PucklaJ/3AHEL_Werkstaettenprojekt/README.md

# 3AHEL_Werkstaettenprojekt
Hier findet man alle Dateien für unser Werktättenprojekt

Jahrgang: 2016/17
Personen:
	- Karayanov Vitaliy
	- Mujic Haris
	- Pucher Jonas

Arbeitszeit: 11x8 Schulstunden
