PucklaJ/3AHEL_Werkstaettenprojekt/Arbeitsnachweis/ARBEITSZEITNACHWEIS KW11.odt

ARBEITSZEITNACHWEIS

3ABCHEL

Werkstättenprojekt 2016/2017

Projektname: RGB-LED-Matrix-Konsole

Datum: 17.03.2017 KW: 11

Status: Schaltplan fast fertig

Name | | Durchgeführte Arbeiten | | Stunden
Mujic Haris | | Auf Steckbrett stecken(Matrix testen) | | 8h
Karayanov Vitaliy | | Auf Steckbrett stecken(Matrix testen) | | 8h
Pucher Jonas | | Auf Steckbrett stecken(Matrix testen), Arduino programmieren | | 8h
| | | Gesamt - Personalstunden | 24h

Datum: 17.03.2017
