PucklaJ/3AHEL_Werkstaettenprojekt/Stückliste.ods

Name | Anzahl | Preis (1 Stk) | Preis | Link | Bestellnummer
32x32 Matrix | 1 | € 63,02 | € 63,02 | https://www.amazon.de/Adafruit-RGB-LED-Panel-32x32-Matrix/dp/B00M40XWBI | Bestellt
Arduino Mega | 1 | € 35,28 | € 35,28 | https://www.amazon.de/Arduino-Mega-2560-R3-Microcontroller/dp/B0046AMGW0 | Bestellt
7 Segment Anzeige | 2 | € 2,97 | € 5,94 | http://at.rs-online.com/web/p/led-displays/8134801/ | 813-4801
Potentiometer | 1 | € 1,92 | € 1,92 | https://www.reichelt.at/4mm-Potis-mono/PO4M-LIN-220K/3/index.html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 | PC16BU 220KA
74HC165 | 4 | € 0,32 | € 1,28 | http://at.rs-online.com/web/p/zahler-und-schieberegister/1776629/ | 177-6629
MAX7219 | 1 | € 7,44 | € 7,44 | http://at.rs-online.com/web/p/zahler-und-schieberegister/7390136/ | 739-0136
DIN-Buchse Console | 4 | € 0,60 | € 2,40 | https://www.reichelt.at/Diodeneinbaubuchsen/MABPM-5S/3/index.html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 | MABPM 5S
Verbindungs-Kabel | 4 | € 1,41 | € 5,64 | https://www.reichelt.at/A-V-Kabel-DIN-/AVK-123/3/index.html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 | AVK 123
Kontrolltaster | 16 | € 1,49 | € 23,84 | http://at.rs-online.com/web/p/tastaturschalter/0102311/?origin=PSF_428099 | 102-311
Aktionstaster | 8 | € 1,43 | € 11,44 | http://at.rs-online.com/web/p/tastaturschalter/0102248/?origin=PSF_428099 | 102-248
Arduino-Buchsenleiste | 1 | € 3,71 | € 3,71 | http://at.rs-online.com/web/p/leiterplatten-buchsen/2304938/ | 230-4938
Buchsen-Buchsenleiste | 2 | € 1,54 | € 3,08 | http://at.rs-online.com/web/p/leiterplatten-buchsen/7655705/ | 765-5705
7Seg-Buchsenleiste | 5 | € 0,45 | € 2,26 | http://at.rs-online.com/web/p/leiterplatten-buchsen/6816823/ | 681-6823
Matrix-Stiftleiste | 1 | € 0,49 | € 0,49 | http://at.rs-online.com/web/p/leiterplatten-header/8323500/ | 832-3500
Spannungsregler | 1 | € 2,95 | € 2,95 | https://www.neuhold-elektronik.at/catshop/product_info.php?products_id=4414 | N9505
Kondensator 100n | 29 | € 0,04 | € 1,16 | https://www.reichelt.at/Vielschicht-SMD-G0805/X7R-0805-CG-100N/3/index.html?ACTION=3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 | X7R 0805 CG 100N
Widerstand 10k | 24 | € 0,02 | € 0,48 | https://www.reichelt.at/SMD-1206-von-1-bis-910-kOhm/RND-1206-1-10K/3/index.html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 | RND 1206 1 10K
Widerstand 200 | 1 | € 0,02 | € 0,02 | https://www.reichelt.at/SMD-1206-von-0-bis-910-Ohm/RND-1206-1-200/3/index.html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 | RND 1206 1 200
Netzteil | 1 | € 13,85 | € 13,85 | https://www.amazon.de/CSL-verschiedene-Adapter-Aufs%C3%A4tze-%C3%9Cberspannung-Kurzschluss/dp/B01MFCR6W2 | Bestellt
 |  | Summe | € 186,20
 |  | Schulrabatt | € 60,00
 |  | Noch zu zahlen | € 87,90
Person | Selbst | Für Schule | Für Jonas | Summe
Mujic Haris | € 4,62 | € 4,68 | € 32,77 | € 42,07
Karayanov Vitaliy | € 4,62 | € 4,68 | € 32,77 | € 42,07
Pucher Jonas | € 4,62 | € 4,68 | € 32,77 | € 42,07
Noch nicht bestellt!!
