PucklaJ/3AHEL_Werkstaettenprojekt/(list of files, cad)

Other CAD files:
3AHEL_LED_Matrix.skp
3AHEL_LED_Matrix_new.skp
