PucklaJ/3AHEL_Werkstaettenprojekt/Eagle_Verzeichnisse/Projekte/Matrix-Konsole/console1_löt_top.pdf

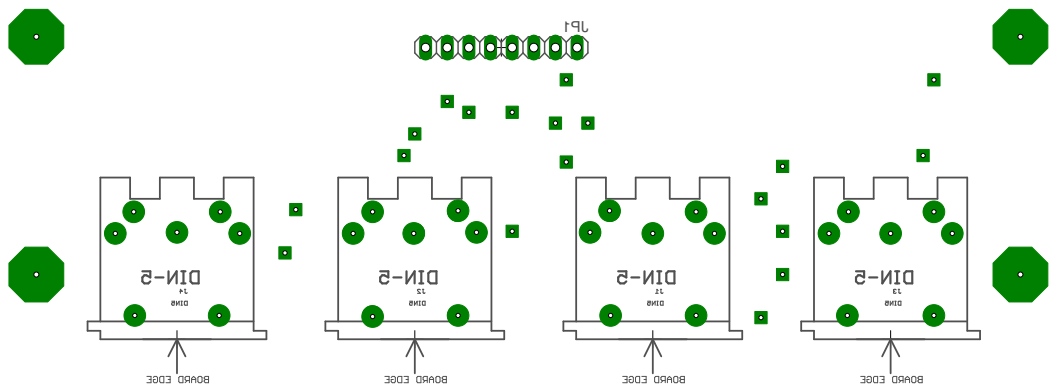
[picture p18: page 1]
