PucklaJ/3AHEL_Werkstaettenprojekt/Eagle_Verzeichnisse/Projekte/Matrix-Konsole/console2_löt_bot.pdf

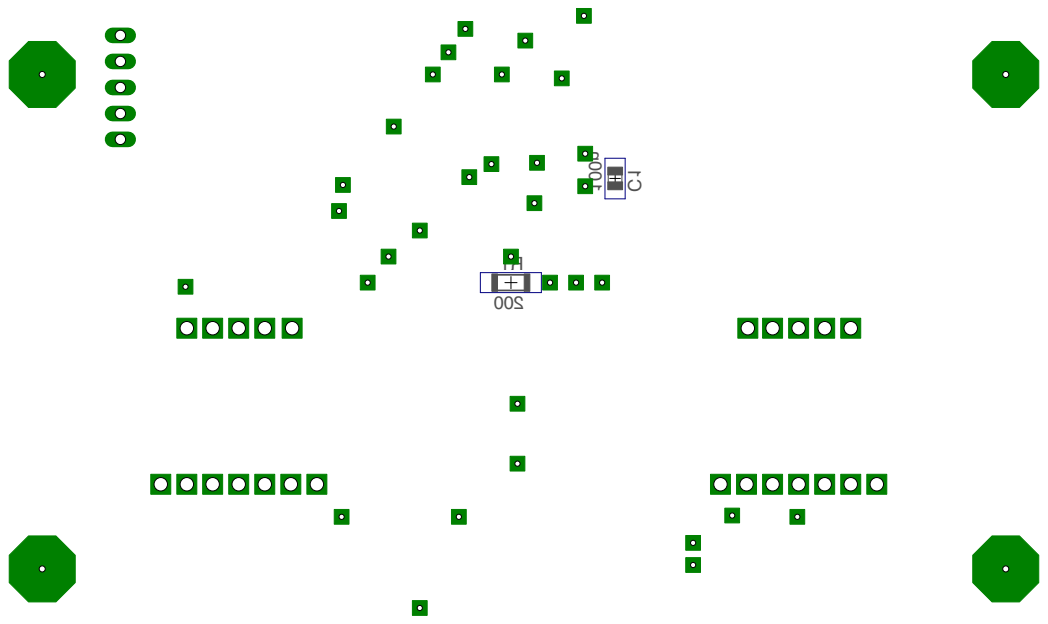
[picture p19: page 1]
