PucklaJ/3AHEL_Werkstaettenprojekt/Eagle_Verzeichnisse/Projekte/Matrix-Konsole/console2_löt_top.pdf

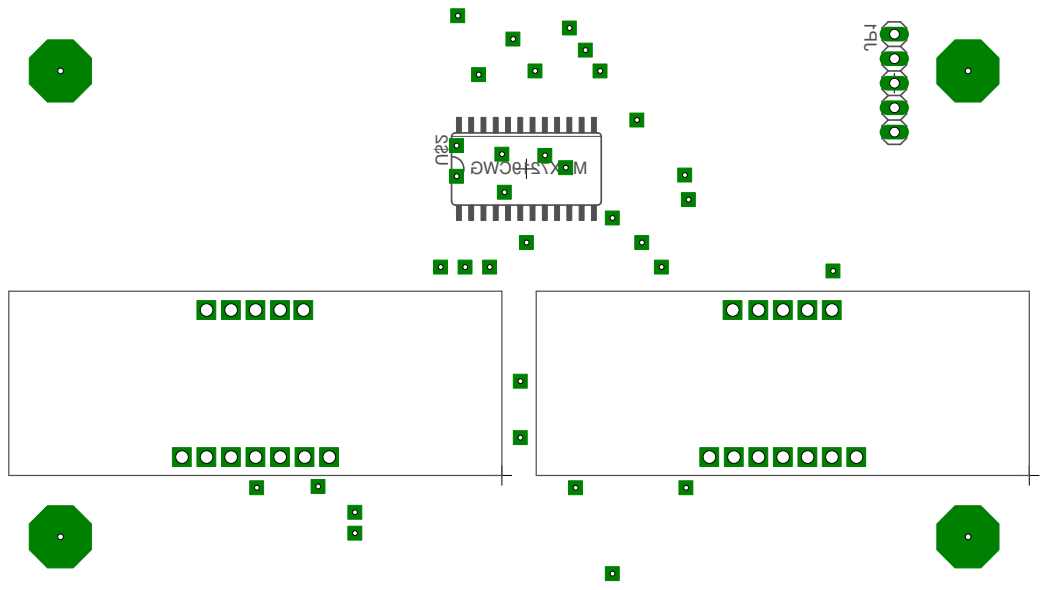
[picture p20: page 1]
