PucklaJ/3AHEL_Werkstaettenprojekt/Eagle_Verzeichnisse/Projekte/Matrix-Konsole/console_löt_top.pdf

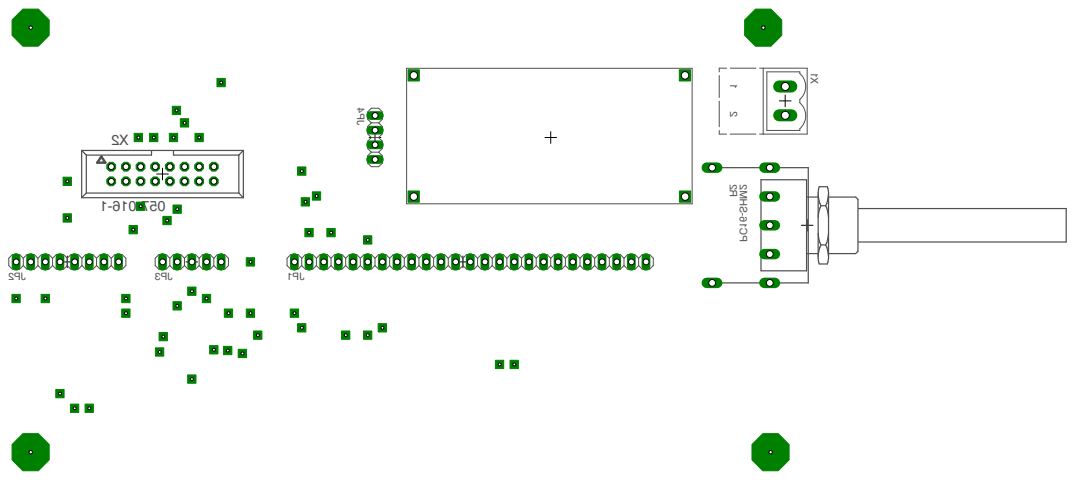
[picture p21: page 1]
