PucklaJ/3AHEL_Werkstaettenprojekt/Eagle_Verzeichnisse/Projekte/Matrix-Konsole/controller_löt_top.pdf

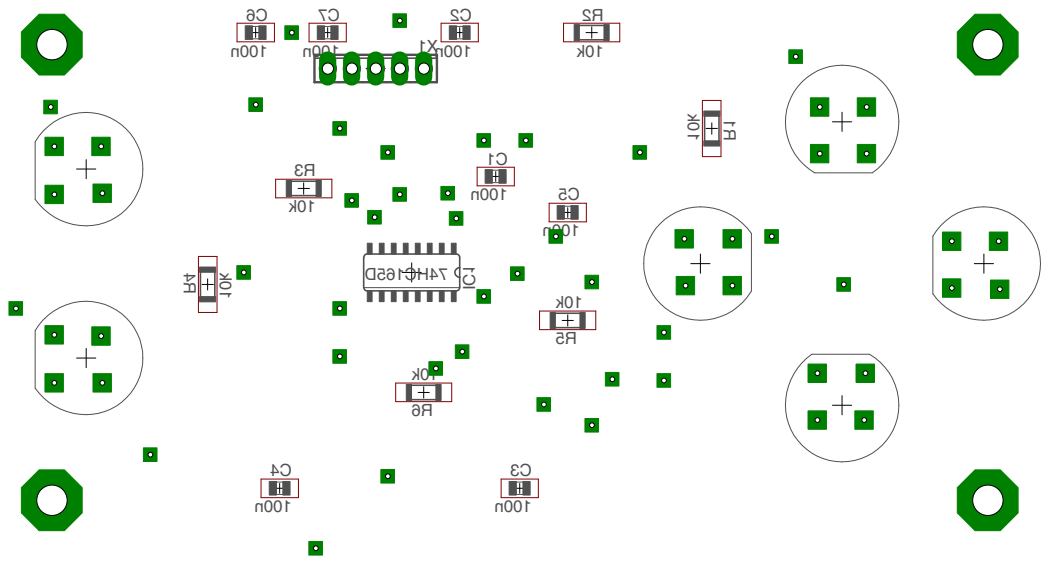
[picture p22: page 1]
