PucklaJ/3AHEL_Werkstaettenprojekt/Eagle_Verzeichnisse/Projekte/Matrix-Konsole/console.pdf

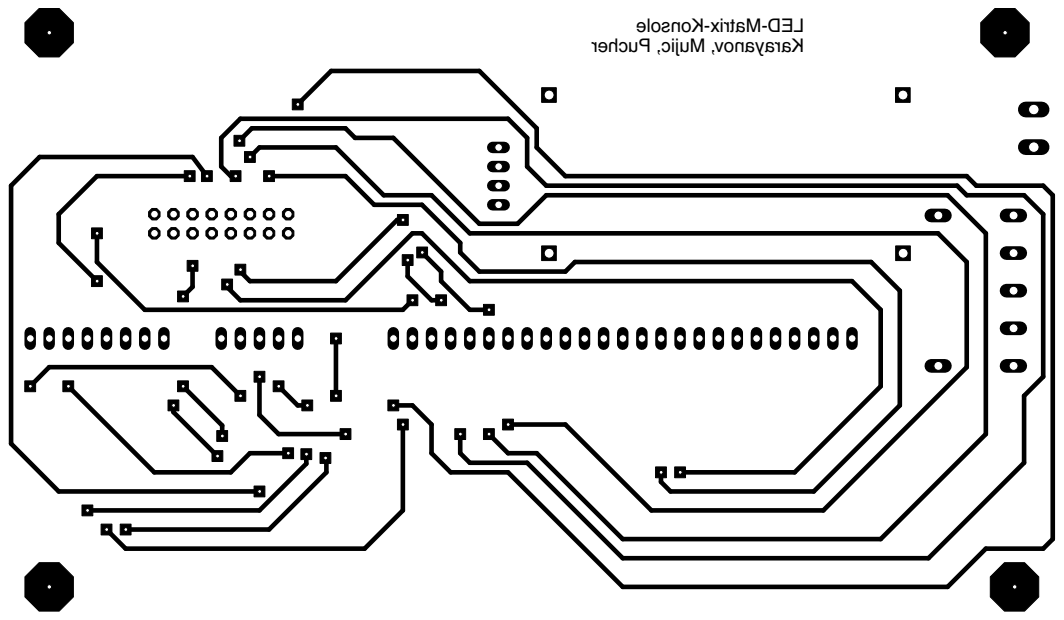
[picture p23: page 1]

el osnoK- xirt a M- DEL

r ehcuP, cij u M, vonayar aK
