PucklaJ/3AHEL_Werkstaettenprojekt/Eagle_Verzeichnisse/Projekte/Matrix-Konsole/console1_top.pdf

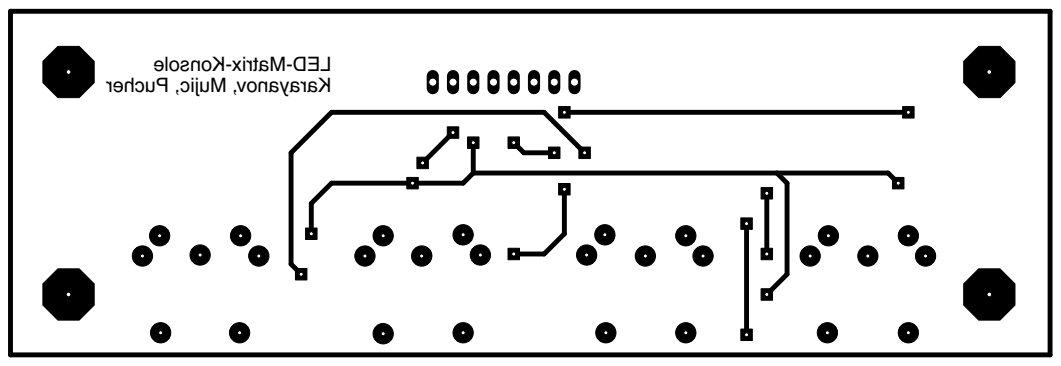
[picture p25: page 1]

el osnoK- xirt a M- DEL

r ehcuP, cij u M, vonayar aK
