PucklaJ/3AHEL_Werkstaettenprojekt/Eagle_Verzeichnisse/Projekte/Matrix-Konsole/console_top.pdf

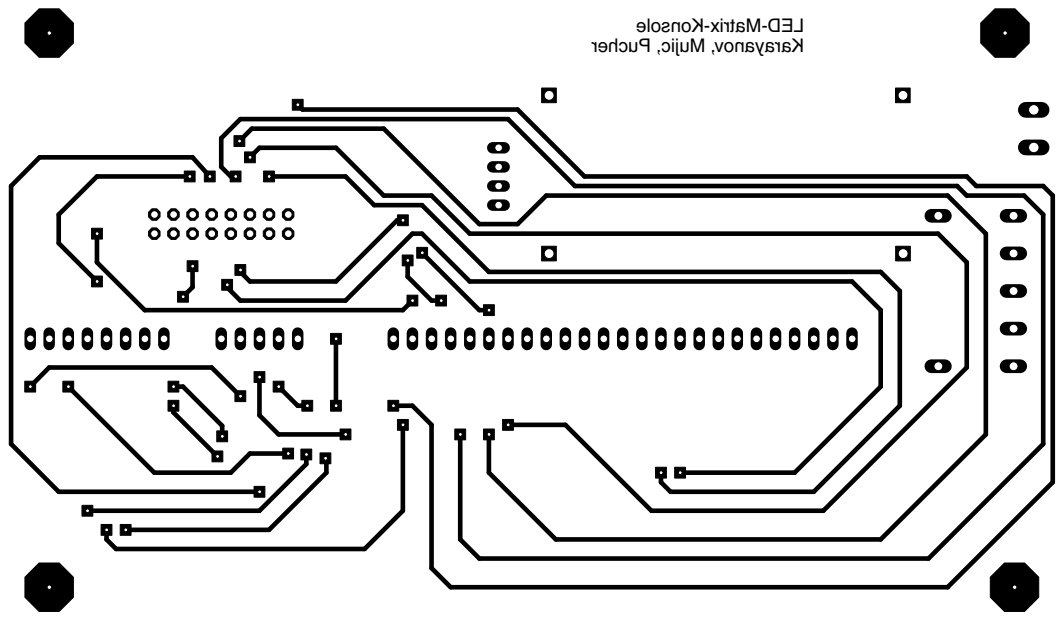
[picture p29: page 1]

el osnoK- xirt a M- DEL

r ehcuP, cij u M, vonayar aK
