PucklaJ/3AHEL_Werkstaettenprojekt/Eagle_Verzeichnisse/Projekte/Matrix-Konsole/controller.pdf

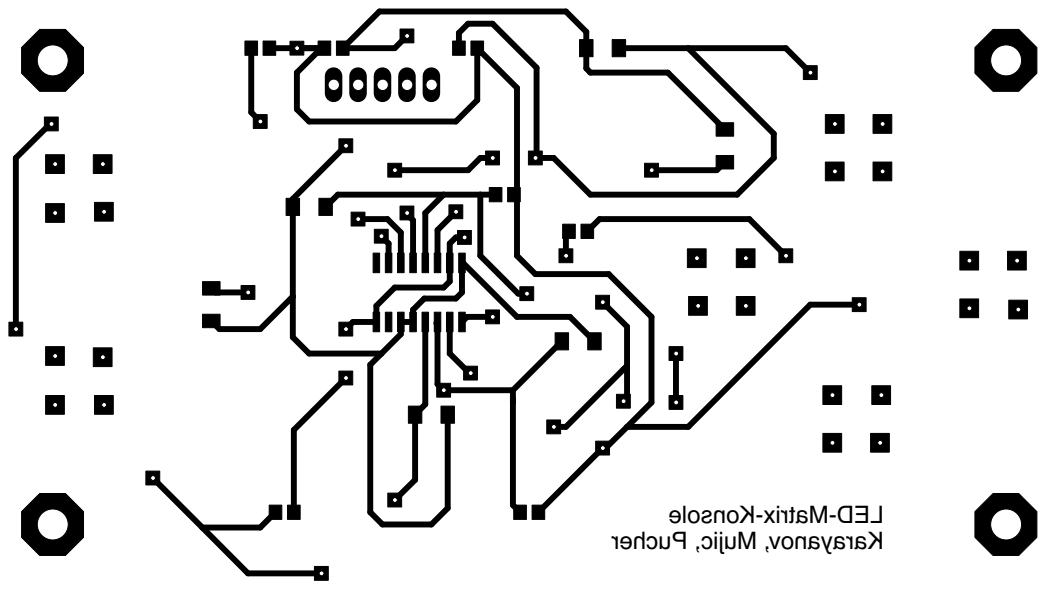
[picture p30: page 1]

el osnoK- xirt a M- DEL

r ehcuP, cij u M, vonayar aK
