PucklaJ/3AHEL_Werkstaettenprojekt/Eagle_Verzeichnisse/Projekte/Matrix-Konsole/controller_top.pdf

el osnoK- xirt a M- DEL

r ehcuP, cij u M, vonayar aK
