PucklaJ/3AHEL_Werkstaettenprojekt/Eagle_Verzeichnisse/Projekte/Matrix-Konsole/controller.brd

## EAGLE design Eagle_Verzeichnisse/Projekte/Matrix-Konsole/controller.brd (2017-04-07)

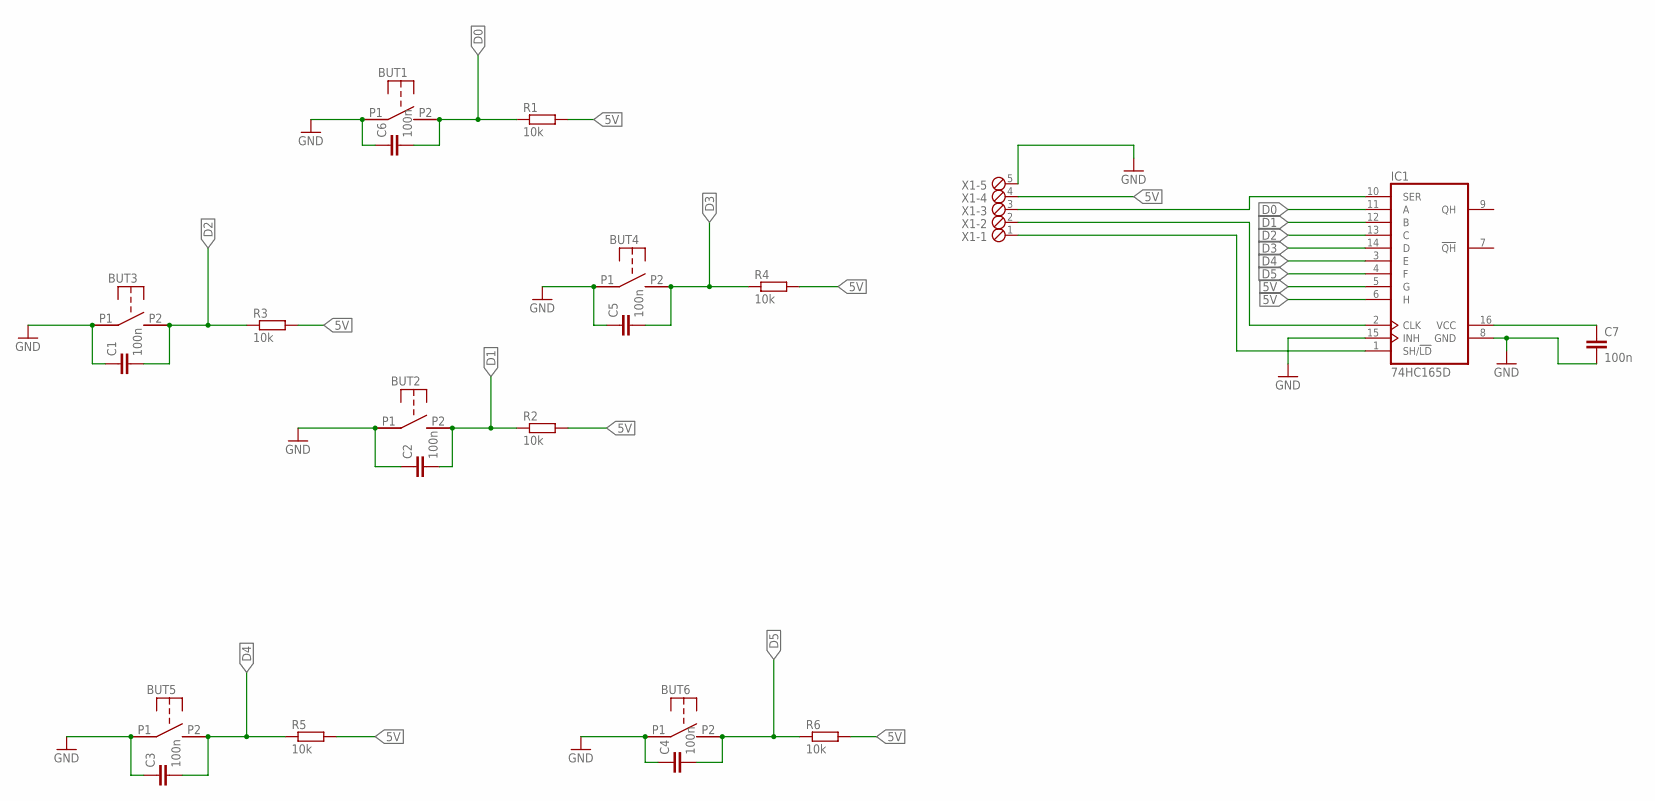
[picture p32: schematic controller.sch]

Parts:
BUT1, BUT2, BUT3, BUT4, BUT5, BUT6: BUTTON_DEV; BUTTON_PACK
C1, C2, C3, C4, C5, C6, C7: 100n; C0805
IC1: 74HC165D; SO16
R1, R2, R3, R4, R5, R6: 10k; M3516
X1: MPT5; 5POL254

Connections:
5V: C7.1, IC1.5 (G), IC1.6 (H), IC1.16 (VCC), R1.2, R2.2, R3.2, R4.2, R5.2, R6.2, X1.4
D0: BUT1.P2, BUT1.P2' (P2), C6.2, IC1.11 (A), R1.1
D1: BUT2.P2, BUT2.P2' (P2), C2.2, IC1.12 (B), R2.1
D2: BUT3.P2, BUT3.P2' (P2), C1.2, IC1.13 (C), R3.1
D3: BUT4.P2, BUT4.P2' (P2), C5.2, IC1.14 (D), R4.1
D4: BUT5.P2, BUT5.P2' (P2), C3.2, IC1.3 (E), R5.1
D5: BUT6.P2, BUT6.P2' (P2), C4.2, IC1.4 (F), R6.1
GND: BUT1.P1, BUT1.P1' (P1), BUT2.P1, BUT2.P1' (P1), BUT3.P1, BUT3.P1' (P1), BUT5.P1, BUT5.P1' (P1), BUT6.P1, BUT6.P1' (P1), C1.1, C2.1, C3.1, C4.1, C6.1, C7.2, IC1.8 (GND), IC1.15 (INH), X1.5
N3: BUT4.P1, BUT4.P1' (P1), C5.1
unnamed: IC1.1 (SH/!LD), X1.1
unnamed: IC1.2 (CLK), X1.2
unnamed: IC1.10 (SER), X1.3

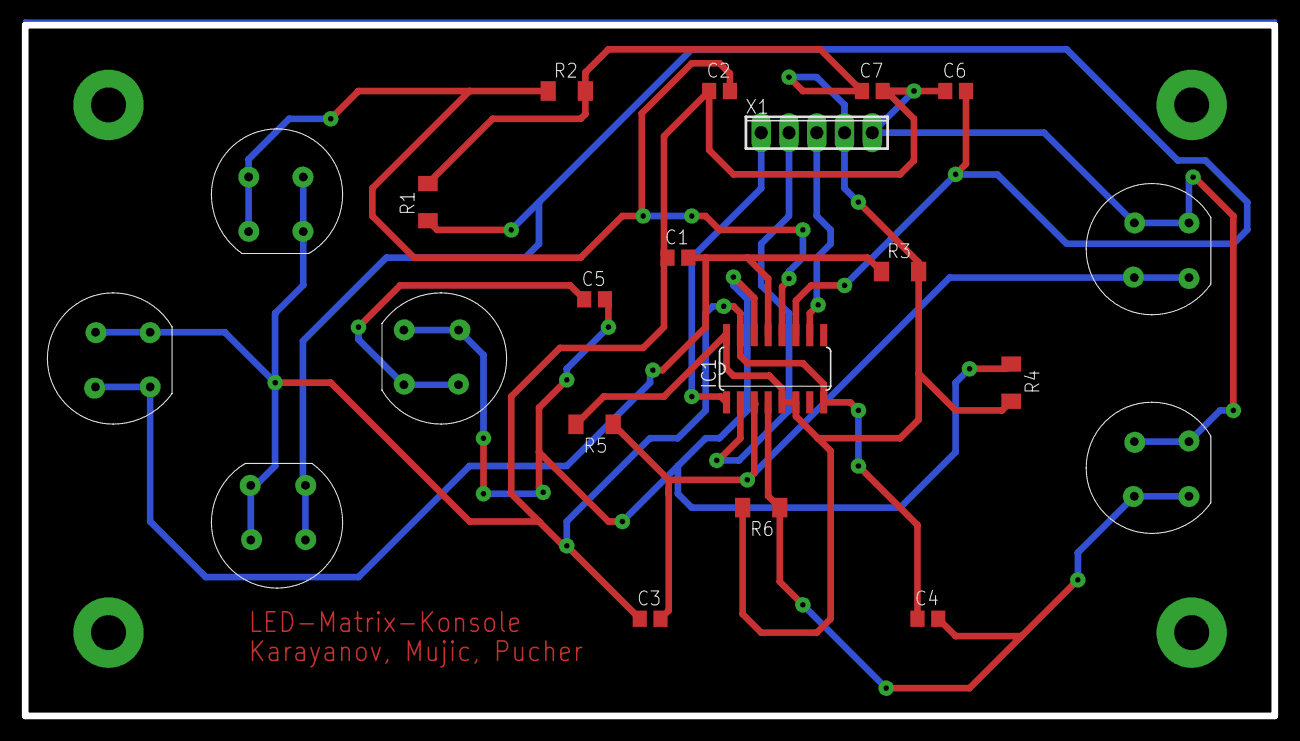
[picture p33: board controller.brd from above]

Board: 2 copper layers, 114.3 x 63.2 mm, 21 parts (0 on the bottom side), 12 nets.
