PucklaJ/3AHEL_Werkstaettenprojekt/Eagle_Verzeichnisse/Projekte/Matrix-Konsole/console2.brd

## EAGLE design Eagle_Verzeichnisse/Projekte/Matrix-Konsole/console2.brd (2017-04-07)

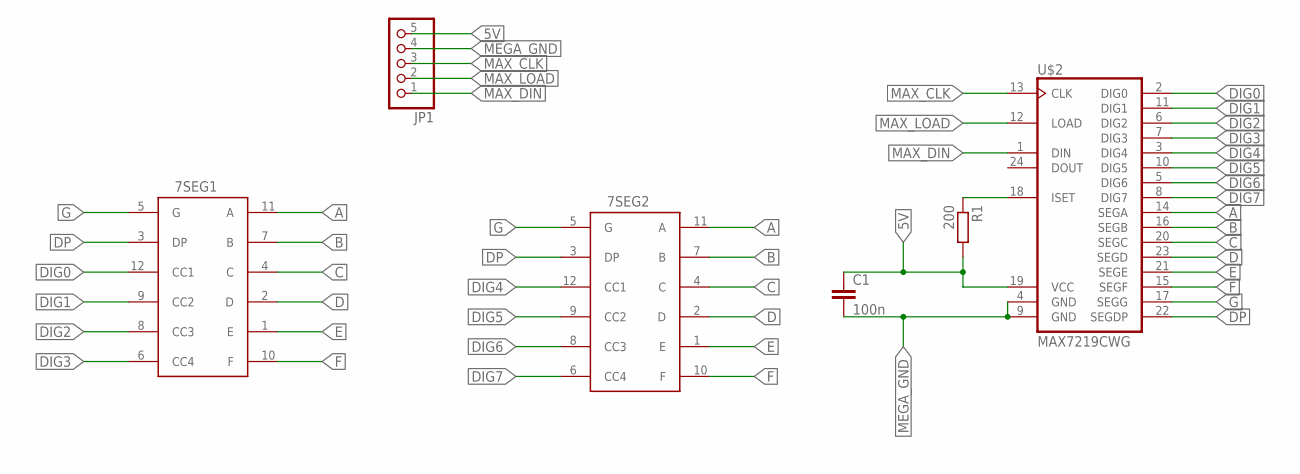
[picture p34: schematic console2.sch]

Parts:
7SEG1, 7SEG2: 7SEG_DEV; 7SEG_PACK
C1: 100n; C0805
JP1: PINHD-1X5; 1X05
R1: 200; M3516
U$2: MAX7219CWG; SO24L

Connections:
5V: C1.1, JP1.5, R1.2, U$2.19 (VCC)
A: 7SEG1.11 (A), 7SEG2.11 (A), U$2.14 (SEGA)
B: 7SEG1.7 (B), 7SEG2.7 (B), U$2.16 (SEGB)
C: 7SEG1.4 (C), 7SEG2.4 (C), U$2.20 (SEGC)
D: 7SEG1.2 (D), 7SEG2.2 (D), U$2.23 (SEGD)
DIG0: 7SEG1.12 (CC1), U$2.2 (DIG0)
DIG1: 7SEG1.9 (CC2), U$2.11 (DIG1)
DIG2: 7SEG1.8 (CC3), U$2.6 (DIG2)
DIG3: 7SEG1.6 (CC4), U$2.7 (DIG3)
DIG4: 7SEG2.12 (CC1), U$2.3 (DIG4)
DIG5: 7SEG2.9 (CC2), U$2.10 (DIG5)
DIG6: 7SEG2.8 (CC3), U$2.5 (DIG6)
DIG7: 7SEG2.6 (CC4), U$2.8 (DIG7)
DP: 7SEG1.3 (DP), 7SEG2.3 (DP), U$2.22 (SEGDP)
E: 7SEG1.1 (E), 7SEG2.1 (E), U$2.21 (SEGE)
F: 7SEG1.10 (F), 7SEG2.10 (F), U$2.15 (SEGF)
G: 7SEG1.5 (G), 7SEG2.5 (G), U$2.17 (SEGG)
MAX_CLK: JP1.3, U$2.13 (CLK)
MAX_DIN: JP1.1, U$2.1 (DIN)
MAX_ISET: R1.1, U$2.18 (ISET)
MAX_LOAD: JP1.2, U$2.12 (LOAD)
MEGA_GND: C1.2, JP1.4, U$2.4 (GND), U$2.9 (GND)

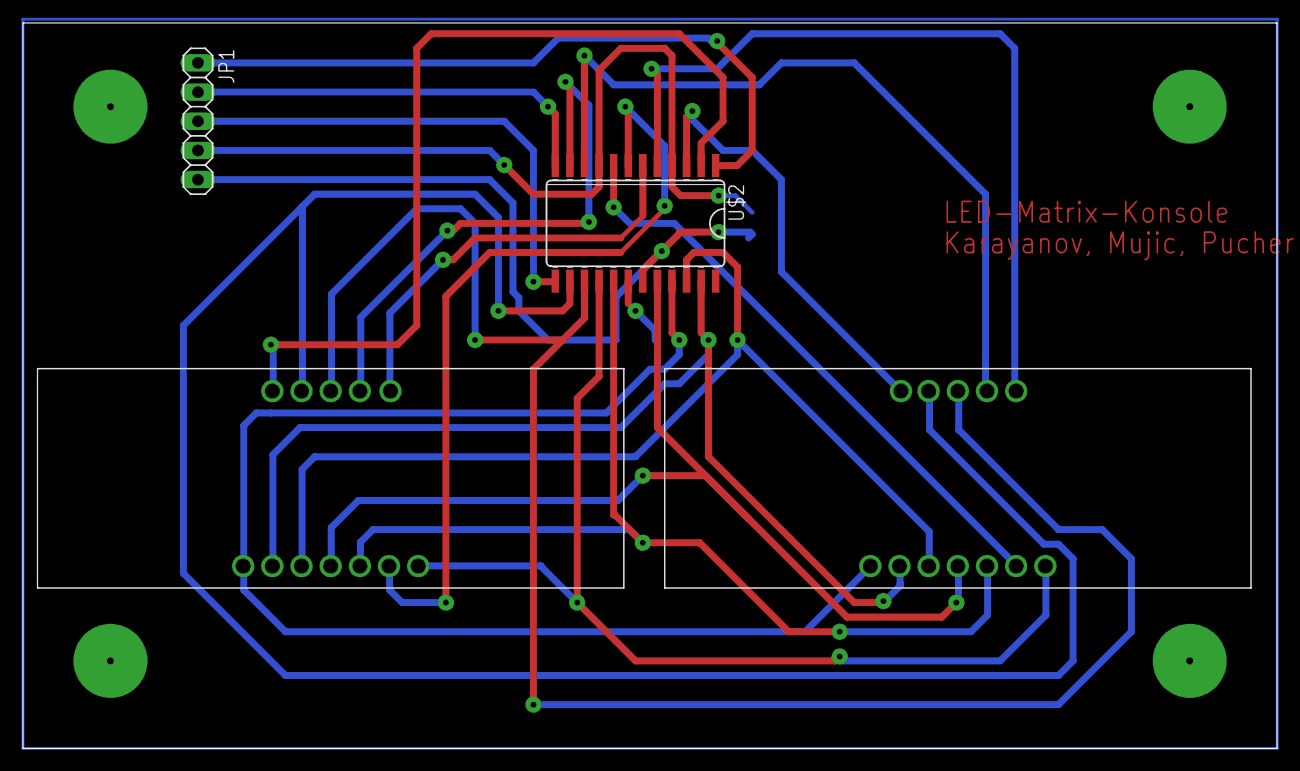
[picture p35: board console2.brd from above]

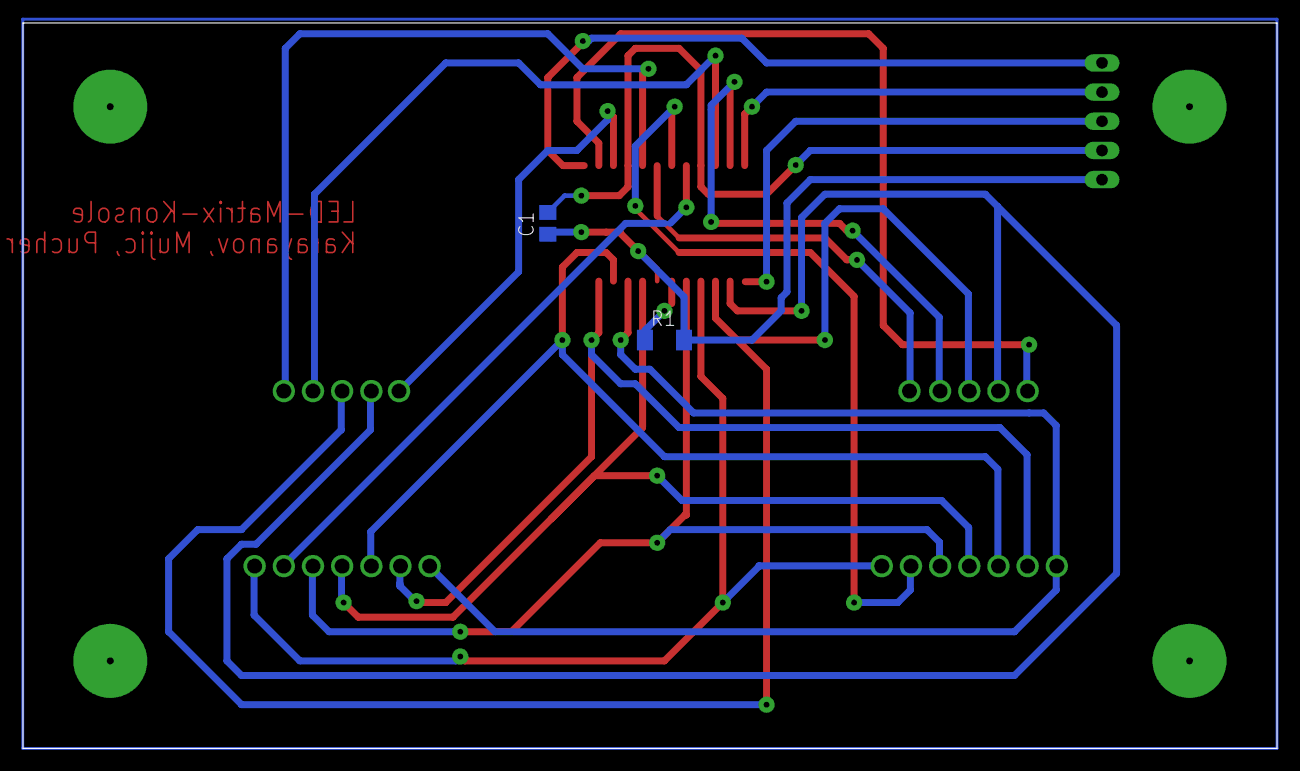
[picture p36: board console2.brd from below]

Board: 2 copper layers, 109.2 x 63.2 mm, 6 parts (2 on the bottom side), 22 nets.
