PucklaJ/3AHEL_Werkstaettenprojekt/Eagle_Verzeichnisse/Projekte/Matrix-Konsole/console1.brd

## EAGLE design Eagle_Verzeichnisse/Projekte/Matrix-Konsole/console1.brd (2017-04-07)

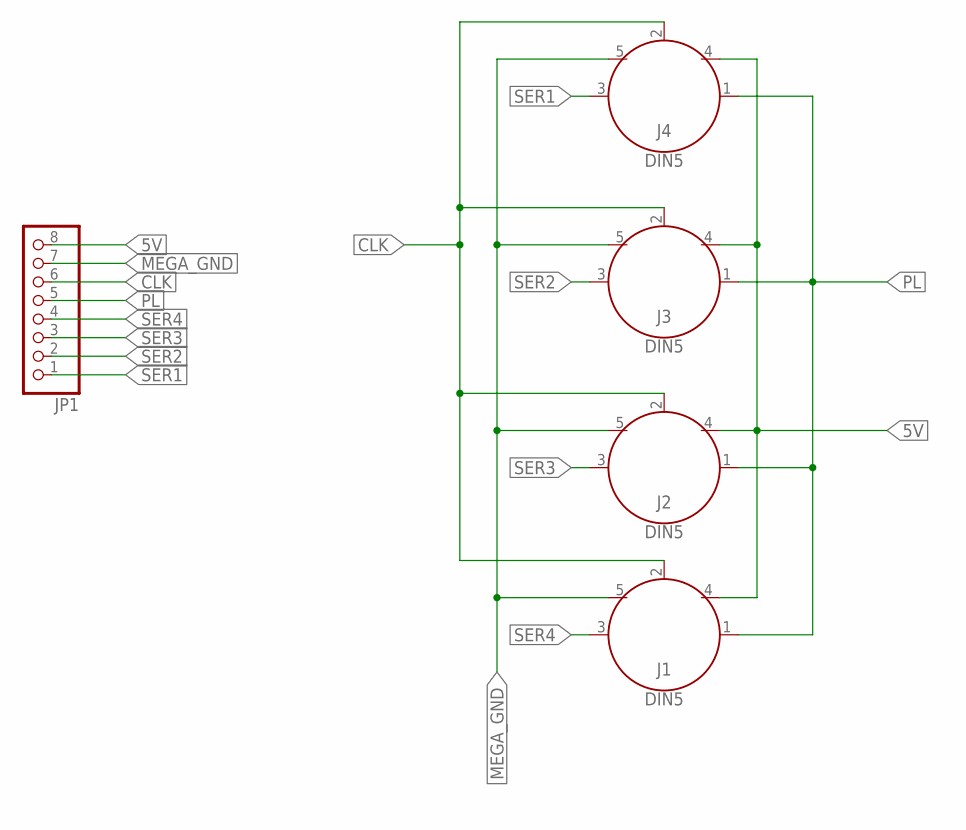
[picture p37: schematic console1.sch]

Parts:
J1, J2, J3, J4: DIN5; DIN5-RA-PTH
JP1: PINHD-1X8; 1X08

Connections:
5V: J1.4, J2.4, J3.4, J4.4, JP1.8
CLK: J1.2, J2.2, J3.2, J4.2, JP1.6
MEGA_GND: J1.5, J2.5, J3.5, J4.5, JP1.7
PL: J1.1, J2.1, J3.1, J4.1, JP1.5
SER1: J4.3, JP1.1
SER2: J3.3, JP1.2
SER3: J2.3, JP1.3
SER4: J1.3, JP1.4

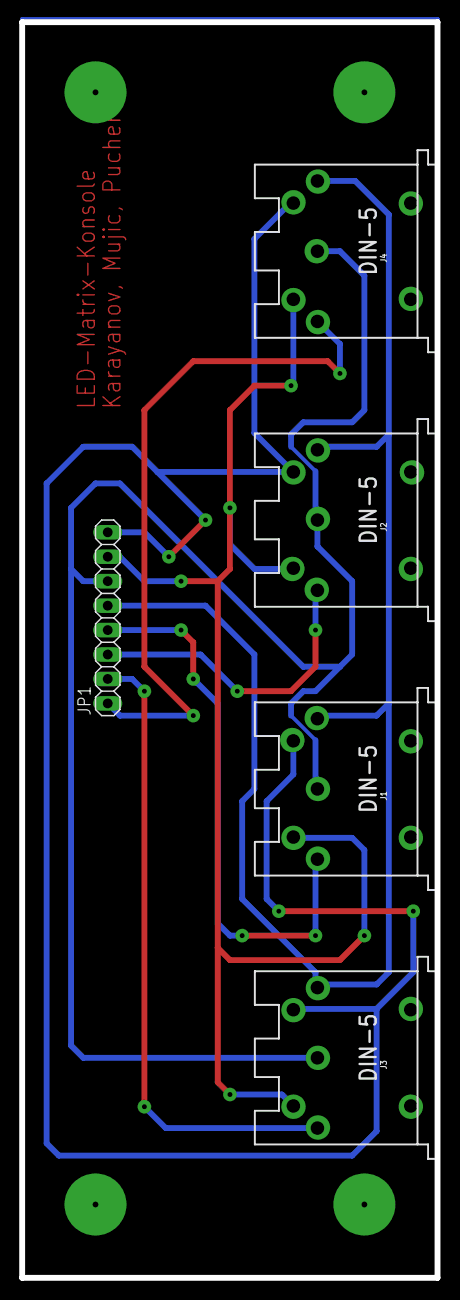
[picture p38: board console1.brd from above]

Board: 2 copper layers, 43.2 x 130.5 mm, 5 parts (0 on the bottom side), 8 nets.
