PucklaJ/3AHEL_Werkstaettenprojekt/Eagle_Verzeichnisse/Projekte/Matrix-Konsole/console.brd

## EAGLE design Eagle_Verzeichnisse/Projekte/Matrix-Konsole/console.brd (2017-04-07)

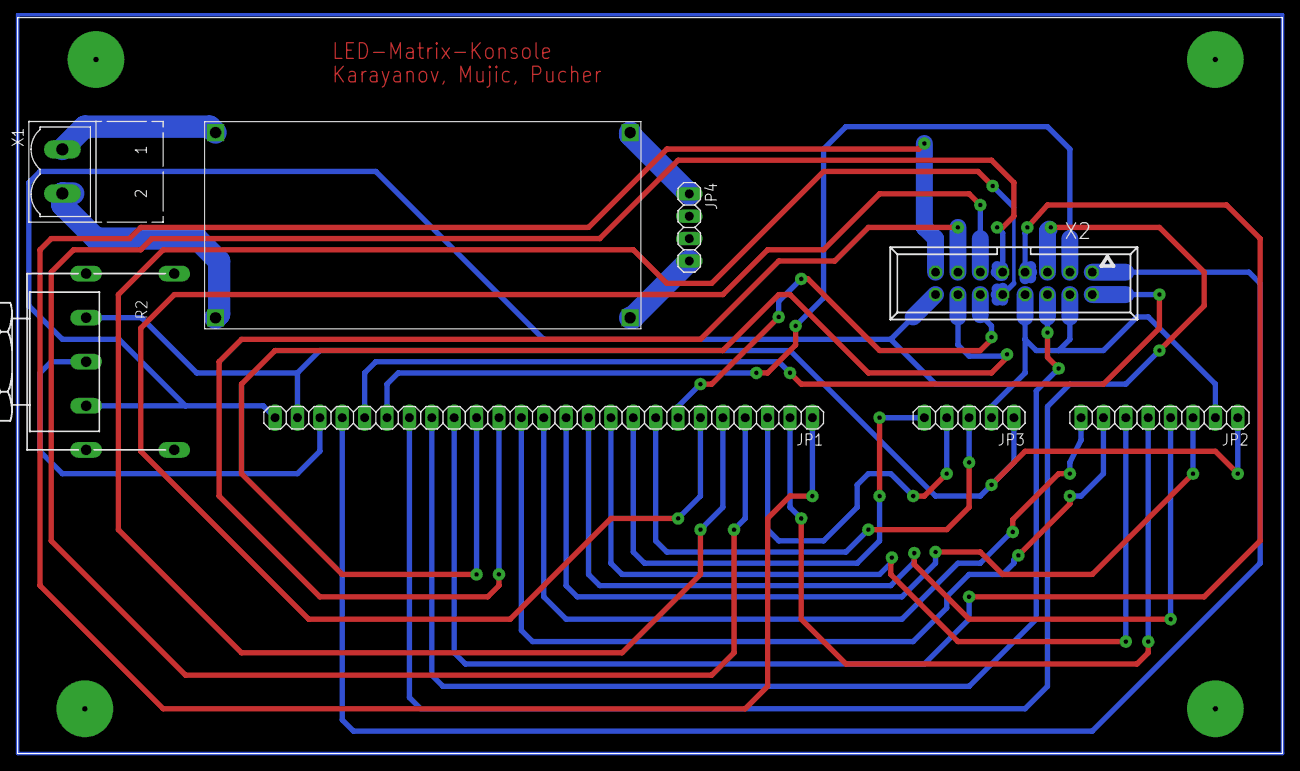
[picture p42: board console.brd from above]

Board: 2 copper layers, 143.5 x 83.5 mm, 8 parts (0 on the bottom side), 29 nets.

Parts:
JP1: 1X25
JP2: 1X08
JP3: 1X05
JP4: 1X04
R2: PC16-SHM2
U$1: SPGRGL_DEV; SPGRGL_PACK
X1: MSTBV2
X2: 057-016-1

Connections:
5V: JP1.24, JP2.1, JP3.1, R2.1A
CLK: JP1.12, JP2.3
GND: U$1.IN-, X1.2
MATRIX_A: JP1.4, X2.9
MATRIX_B: JP1.5, X2.10
MATRIX_B1: JP1.20, X2.3
MATRIX_B2: JP1.17, X2.7
MATRIX_C: JP1.6, X2.11
MATRIX_CLK: JP1.15, X2.13
MATRIX_D: JP1.7, X2.12
MATRIX_G1: JP1.21, X2.2
MATRIX_G2: JP1.18, X2.6
MATRIX_GND: JP4.4, U$1.OUT-
MATRIX_LAT: JP1.16, X2.14
MATRIX_OE: JP1.1, X2.15
MATRIX_R1: JP1.22, X2.1
MATRIX_R2: JP1.19, X2.5
MATRIX_VCC: JP4.1, U$1.OUT+
MAX_CLK: JP1.8, JP3.3
MAX_DIN: JP1.9, JP3.5
MAX_LOAD: JP1.3, JP3.4
MEGA_A9: JP1.23, R2.1S
MEGA_GND: JP1.25, JP2.2, JP3.2, R2.1E, X2.4, X2.8, X2.16
PL: JP1.11, JP2.4
SER1: JP1.13, JP2.8
SER2: JP1.14, JP2.7
SER3: JP1.10, JP2.6
SER4: JP1.2, JP2.5
VCC: U$1.IN+, X1.1
