PucklaJ/3AHEL_Werkstaettenprojekt/src/ConsoleClass/Game.cpp

#include "Game.h"
#include "Console.h"

Game::Game(Console* _console) : console(_console)
{

}

Game::~Game()
{

}

void Game::init()
{

}

void Game::update()
{

}

void Game::render()
{

}

void Game::quit()
{
	
}

void Game::menu_init()
{

}

void Game::menu_update()
{

}

void Game::menu_render()
{

}

void Game::menu_quit()
{
  
}
