PucklaJ/3AHEL_Werkstaettenprojekt/(commit log)

2017-03-03 Added Schaltplan Ordner
    [Konsole.sch]
2017-03-10 Added a few files
    [untitled.sch]
2017-03-10 Added a new Arbeitsnachweis and documentation
    [Schaltplan.sch]
2017-03-10 Added Stückliste
    [Arduino_MEGA_2560-Rev3.brd, Arduino_MEGA_2560-Rev3.sch, Schaltplan.sch, Stückliste.ods]
2017-03-11 Added a few parts to circuit diagram
    [console.sch, controller.sch, untitled.sch]
2017-03-11 Added circuit diagrams, Changed Stückliste
    [Arduino_MEGA_2560-Rev3.brd, Arduino_MEGA_2560-Rev3.sch, Konsole.sch, Stückliste.ods, console.sch]
2017-03-11 Changed 79HC to 74HC in Stückliste
    [Stückliste.ods]
2017-03-12 Removed USB, Changed Labels
    [console.sch, controller.sch]
2017-03-17 Added MAX7219 Library
    [console.sch, controller.sch]
2017-03-17 Added Source Code
    [controller.sch]
2017-03-17 Added MAX7219, Added Potentiometer, Made curcuit diagram clearer, Changed Connectors
    [console.sch, controller.sch]
2017-03-17 Added Board to console, Added Pin header
    [Stückliste.ods, console.brd, console.sch, controller.sch]
2017-03-19 Added Z-Diode
    [Stückliste.ods, console.brd, console.sch, controller.sch]
2017-03-19 Changed z-Diode-resistor to 10 Ohm
    [Stückliste.ods, console.sch]
2017-03-22 Changed the matrix board
    [console.brd, console.sch, controller.sch]
2017-03-24 Added Spannungsregler
    [console.brd, console.sch]
2017-03-24 Added Layout for console
    [Stückliste.ods, console.brd, console.sch, controller.sch]
2017-03-31 Added Bestellnumnmern to Stückliste, Added Bohrungen to console-layout
    [Stückliste.ods, console.brd]
2017-03-31 Added controller-layout, Improved console-layout
    [console.brd, controller.brd]
2017-03-31 Improved layouts
    [console.brd, controller.brd]
2017-04-06 Splitted the console-layout into three boards and improved the layouts
    [Stückliste.ods, console.brd, console.sch, console1.brd, console1.sch, console2.brd, console2.sch, controller.brd]
2017-04-07 Made final changes to the layout and added PDF-Files
    [console.brd, console1.brd, console2.brd, controller.brd]
2017-05-17 Added Package_sketch
    [3AHEL_LED_Matrix.skp, 3AHEL_LED_Matrix_new.skp]
